ErickMS27/projeto_robo/docs/referencias.md

# Referências técnicas

Lista do manual ROB4M MT 001 Rev. 1.0 (consulta às fontes em 28/10/2026). Para o BMS, os motores,
os servos, o sensor IR e os módulos efetivamente instalados, acrescentar a documentação do modelo
usado e salvar o PDF em [pdfs/](pdfs/).

| Nº | Referência | Link |
|---|---|---|
| [1] | Arduino UNO R3 — Documentação da placa | https://docs.arduino.cc/hardware/uno-rev3/ |
| [2] | STMicroelectronics L298 — Datasheet DS0218 revisão 5 | https://www.st.com/resource/en/datasheet/l298.pdf |
| [3] | Handson Technology — L298N Dual H Bridge Motor Driver User Guide | https://www.handsontec.com/dataspecs/module/L298N%20Motor%20Driver.pdf |
| [4] | Texas Instruments LM2596 — Dados técnicos e aplicações | https://www.ti.com/product/LM2596 |
| [5] | Arduino — What power supply can I use with my Arduino board | https://support.arduino.cc/hc/en-us/articles/360018922259-What-power-supply-can-I-use-with-my-Arduino-board |
| [6] | ElecFreaks — Ultrasonic Ranging Module HC-SR04 Datasheet | https://cdn.sparkfun.com/datasheets/Sensors/Proximity/HCSR04.pdf |
| [7] | Arduino — Biblioteca Servo, definição dos timers AVR | https://github.com/arduino-libraries/Servo/blob/master/src/avr/ServoTimers.h |
| [8] | Pololu — Suporte técnico sobre dois motores por canal | https://forum.pololu.com/t/mdo3a-2-motors-per-channel/21333 |
| [9] | Texas Instruments — Família LM7800 e LM7805 | https://www.ti.com/product/LM7800 |
| [10] | Arduino — Secrets of Arduino PWM, pinos e temporizadores | https://docs.arduino.cc/tutorials/generic/secrets-of-arduino-pwm/ |

## Materiais do projeto

- Cópia de diagnóstico no Tinkercad: [Robo diagnostico com 2 motores](https://www.tinkercad.com/things/iRuOsUpIP9L/editel)
- Esquema exportado do Tinkercad em arquivo BRD, identificado como *Dazzling Amur-Turing*
- Programa de teste do projeto: [teste_conexoes.ino](../montagem/firmware/teste_conexoes/teste_conexoes.ino)

Os resultados de simulação são observações do circuito analisado. Não constituem especificação do
fabricante nem demonstram um limite geral do Tinkercad.

## Modelos instalados

| Componente | Fabricante / modelo | Documento | Arquivo em pdfs/ |
|---|---|---|---|
| Motores CC | | | |
| Servomotores | | | |
| Sensor IR | | | |
| BMS 2S | | | |
| Células 18650 | | | |
| Módulo L298N | | | |
| Módulo LM2596 | | | |
