ErickMS27/projeto_robo/docs/regs/MODELO_registro_de_ensaios.md

# Registro dos ensaios (Apêndice B)

> Copiar este arquivo para `AAAA-MM-DD_descricao.md` nesta pasta e preencher durante a montagem
> física. Os valores observados no Tinkercad **não** devem ocupar os campos destinados às medições
> do carrinho.

## Identificação

| Campo | Registro |
|---|---|
| Responsável e data | |
| Modelos dos motores e servos | |
| Módulos L298N, LM2596 e BMS | |
| Identificação das células e carregador | |
| Versão do programa | |

## Medições

| Item | Sem acionamento | Durante acionamento |
|---|---|---|
| Tensão do pack | | |
| VIN junto ao Uno | | |
| 5 V dos sensores e da lógica | | |
| 5 V junto aos servos | | |
| Corrente do par esquerdo | | |
| Corrente do par direito | | |
| Comportamento térmico | | |

## Resultado por etapa

| Etapa | Resultado | Observação |
|---|---|---|
| T01 a T02 | Aprovado / Reprovado | |
| T03 a T04 | Aprovado / Reprovado | |
| T05 a T06 | Aprovado / Reprovado | |
| T07 a T08 | Aprovado / Reprovado | |

## Intervenções realizadas

-

## Conclusão do ensaio e restrições de uso

-
