ErickMS27/projeto_robo/docs/ORIENTAÇÕES.md

# Datasheets dos modelos instalados

Salvar aqui os PDFs dos fabricantes dos componentes **realmente usados** no carrinho, com o nome
no formato `componente_fabricante_modelo.pdf` (ex.: `servo_towerpro_sg90.pdf`).

Indicar na ficha correspondente em [../componentes/](../componentes/) qual arquivo desta pasta foi
usado como fonte.

Após atualizações drásticas ou requisiões novas solicitadas pelo o Professor Sandro na produção do firmware e na montagem do Projeto, indico à equipe de DATASHEET para que realizem a revisão de validação da documentação desse firmware para a realização do versionamento.

* Início Versionamento:

DOCUMENTAÇÃO TÉCNICA - Versão 0.1 - 28/10/2026
