ErickMS27/projeto_robo/components/l298n.md

# Ponte H L298N

**No projeto:** canal A aciona ME1 + ME2 (lado esquerdo); canal B aciona MD1 + MD2 (lado direito).
**Referências:** [2] Datasheet do L298 (ST), [3] Guia do módulo L298N (Handson), [8] Dois
motores por canal (Pololu) ([referencias.md](../referencias.md)).

## Modelo instalado

| Campo | Valor |
|---|---|
| Fabricante / marcação da placa | |
| Marcação do borne de potência (VS, VMS, +12V...) | |
| Regulador 5 V na placa (modelo) | |
| Diodos de roda livre na placa (sim/não, modelo) | |
| Dissipador | |
| Datasheet usado | |
| Responsável pela ficha | |

## Dados de referência — circuito integrado L298

| Parâmetro | Valor | Fonte |
|---|---|---|
| Estrutura | Dupla ponte H completa | [2] |
| Tensão de potência VS | Até 46 V (limite absoluto) | [2] |
| Tensão lógica VSS | 4,5 a 7 V (típico 5 V) | [2] |
| Corrente por canal, contínua | 2 A (tabela de limites absolutos) | [2] |
| Corrente de pico repetitiva / não repetitiva | 2,5 A / 3 A | [2] |
| Potência total | 25 W com a cápsula a 75 °C | [2] |
| Queda total de tensão a 1 A | Típico 1,8 V, máximo 3,2 V; varia com corrente e temperatura | [2] |
| Entrada lógica | LOW até 1,5 V; HIGH a partir de 2,3 V | [2] |
| Diodos para carga indutiva | Externos, de recuperação rápida | [2] |

Os valores de 2 A são do **circuito integrado**. Não garantem que um módulo qualquer sustente essa
corrente nas condições do carrinho: placa, ventilação, dissipador e temperatura limitam o uso.

## Tabela de controle

| EN | IN1 (IN3) | IN2 (IN4) | Resultado | Função no firmware |
|---|---|---|---|---|
| PWM | HIGH | LOW | Frente | `motoresMover(+v, ...)` |
| PWM | LOW | HIGH | Ré | `motoresMover(-v, ...)` |
| HIGH | igual | igual | Parada rápida (frenagem) | `motoresFrear()` |
| LOW | qualquer | qualquer | Parada por roda livre | `motoresParar()` |

## Uso neste projeto

- Jumpers **ENA e ENB removidos** (PWM vindo de D3 e D11).
- Jumper **5V-EN removido**: lógica alimentada pelo 5V do Arduino no borne lógico do módulo.
- A corrente de cada canal é a **soma** dos dois motores do lado (partida, carga e travamento).
- PWM 150 corresponde a 58,8 % da escala; a tensão média nos motores ainda sofre a queda da ponte
  (ver [dimensionamento](../dimensionamento.md)). A queda não deve ser usada como regulador.

## Confirmar no componente real

- [ ] Função de cada jumper e borne na placa usada (não usar desenho genérico)
- [ ] Modo de lógica externa (5V-EN removido) descrito na documentação desta placa
- [ ] Presença de diodos de roda livre
- [ ] Corrente medida de cada par (livre e na partida) comparada ao limite do módulo
- [ ] Temperatura do módulo após T06 e T07
