ErickMS27/projeto_robo/components/lm2596.md

# Conversor LM2596

**No projeto:** reduz a tensão do ramo S1 para **5,0 V** e alimenta apenas os servos SV1 e SV2.
**Referência:** [4] LM2596 (Texas Instruments) ([referencias.md](../referencias.md)).

## Modelo instalado

| Campo | Valor |
|---|---|
| Fabricante / marcação do módulo | |
| Versão do CI (ajustável / fixa) | |
| Corrente informada pelo vendedor do módulo | |
| Datasheet usado | |
| Responsável pela ficha | |

## Dados de referência — circuito integrado LM2596

| Parâmetro | Valor | Fonte |
|---|---|---|
| Tipo | Regulador chaveado abaixador (step-down / buck) | [4] |
| Corrente de saída | 3 A | [4] |
| Tensão de entrada | Até 40 V | [4] |
| Saída da versão ajustável | 1,2 a 37 V | [4] |
| Frequência de chaveamento | 150 kHz | [4] |

O limite de 3 A do **circuito integrado** não equivale à corrente contínua garantida de qualquer
módulo montado (indutor, capacitores, trilhas e temperatura do módulo também limitam).

## Uso neste projeto

- IN+ no ramo S1, IN- e OUT- no GND comum.
- Ajuste para 5,0 V **com os servos desconectados**; depois medir com os servos em movimento.
- A saída **não** é ligada ao 5V do Arduino nem ao VIN.
- Corrente que o conversor puxa do pack: ver [dimensionamento](../dimensionamento.md), item 5.

## Margem de entrada

Um conversor abaixador precisa de tensão de entrada acima da saída. Com o pack 2S perto do fim da
descarga, a diferença entre o pack e os 5 V fica pequena e a saída pode cair. Medir os 5 V junto aos
servos com o pack baixo e durante as partidas (T07).

## Rendimento

Medir no carrinho: η = (V<sub>saída</sub> × I<sub>saída</sub>) / (V<sub>entrada</sub> × I<sub>entrada</sub>).

| Condição | V entrada | I entrada | V saída | I saída | η |
|---|---|---|---|---|---|
| Servos parados | | | | | |
| Servos em movimento | | | | | |
| Servos sustentando carga | | | | | |

## Confirmar no componente real

- [ ] Saída ajustada em 5,0 V e compatível com os servos
- [ ] Tensão junto aos servos durante movimento e com o pack baixo
- [ ] Aquecimento do módulo
