ErickMS27/projeto_robo/sketches/Modelo de Montagem Base.jpeg

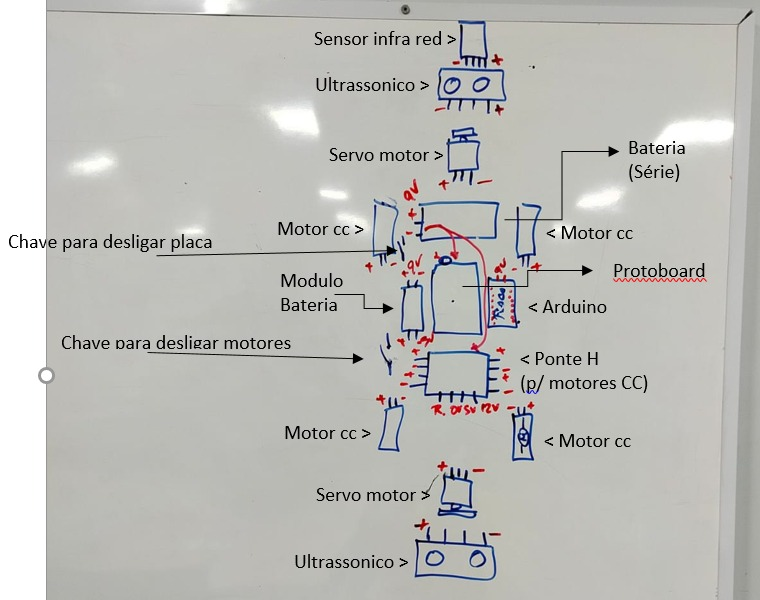
sketches/Modelo de Montagem Base.jpeg
