ErickMS27/projeto_robo/(commit log)

2026-10-28 Estrutura do projeto dividida por equipes
    Organiza o repositório a partir do manual técnico ROB4M MT 001 Rev. 1.0
    em três frentes de trabalho: Montagem, Programação e Datasheet.
    - docs: manual técnico, equipes e responsabilidades, pinagem oficial
    - montagem: roteiros de montagem mecânica e elétrica, chicotes, ensaios
    de bancada T01 a T08, diagnóstico, modelo do registro de ensaios e
    sketches de bancada (programa de teste do Apêndice A, sensores, servos
    e motores)
    - programacao: firmware do carrinho autônomo com desvio de obstáculos,
    varredura dos servos e frenagem pelo IR, e registro da simulação no
    Tinkercad
    - datasheet: fichas técnicas dos componentes, dimensionam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
2026-10-28 HOTFIX - Correção de Diretórios
2026-10-28 IMPLEMENT - Modelo de Montagem Base e SKETCH
